maverstr/Lick-Sensor/BillOfMatLickSensor.xlsx

Sheet: Main Material
Material | RS-Reference | URL | Price per component(£, ex. VAT) | Number of components
Arduino Uno | 769-7409 | https://uk.rs-online.com/web/p/processor-microcontroller-development-kits/7697409/ | 15.63 | 1
Hammond 1591, ABS Enclosure, 120x120x94mm | 493-6026 | https://uk.rs-online.com/web/p/general-purpose-enclosures/4936026/ | 10.05 | 1
Solenoid valves VDW22LA | 873-2613 | https://uk.rs-online.com/web/p/solenoid-valves/8732613/ | 18.97 | 2
BNC Connectors | 546-3995 | https://uk.rs-online.com/web/p/bnc-connectors/5463995/ | 2.49 | 4
Push-buttons SPST |  |  | 0.2 | 2
Toggle switches SPST | 419-855 | https://uk.rs-online.com/web/p/toggle-switches/0419855/ | 1.12 | 2
XT60 connectors male | 180-5368 | https://uk.rs-online.com/web/p/compact-power-connectors/1805368/ | 0.768 | 3
XT60 connectors female | 180-5371 | https://uk.rs-online.com/web/p/compact-power-connectors/1805371/ | 0.768 | 3
DC socket 2.5mm | 476-151 | https://uk.rs-online.com/web/p/dc-power-sockets/0476151/ | 6.45 | 1
Pipe to valve adapter, pipes, flow reduction clamp |  |  | 0 | 0
Main material Total |  |  | 87.278
Full total including electronics component sheet: |  |  | 101.003
Full total including electronics component sheet and PCB: |  |  | 116.003
NOTE: Prices are mainly listed from RS components, VAT excluded. Prices taken 24/09/2019.

Sheet: Electronics components
Expensive components | RS-Reference | URL | Price per component(£, ex. VAT) | Number of components
DC/D switching regulators: TSR1-2490 | 666-4376 | https://uk.rs-online.com/web/p/switching-regulators/6664376/ | 6.8 | 1
logic-level MOSFET: IRL540 | 541-1219 | https://uk.rs-online.com/web/p/mosfets/5411219/ | 1.98 | 2
Expensive components Total |  |  | 10.76
Cheap components | RS-Reference | URL | Price per component(£, ex. VAT) | Number of components
Wires |  |  | 0 | 0
Pin headers | 251-8351 | https://uk.rs-online.com/web/p/pcb-headers/2518351/ | 0.725 | 1
Stackable pin headers | Farnell: CN18765 | https://cpc.farnell.com/pro-signal/18689/header-female-stackable-2-54mm/dp/CN18765 | 0.37 | 5
BJT BC547 (or PN2222A, note the reversed pin order) | 671-1113 | https://uk.rs-online.com/web/p/bjt-bipolar-transistors/6711113/ | 0.195 | 2
Cheap components Total: |  |  | 2.965
Resistors (ohms) | Number
10M | 2
1M | 2 | Note:the resistors listed here are the ideal values. A margin of 50-150% is good enough. You can also always place multiple resistors in series or parallel. You may need to slightly adapt the PCB in such case if you don't feel confident soldering multiple resistors on the same slot.
47k | 1
10k | 1
100 | 2
Capacitors (F) | Number
10pF | 1
2.2µF | 1 | not needed if 5V is not used in your design
1µF | 2 | only if your DC/DC converter does not come with integrated filtering capacitors (the TSR1-2490 does implement them)
Diode | Number
1N4001 | 2 | superior voltage diode are also good such as 1N4004
PCB Ordering £1.61 from JLCPCB, additional shipping costs to Leeds, UK using DHL international shipping. Total cost around £15.
