maverstr/Lick-Sensor/Solidworks/xt60MountedPanel.SLDASM

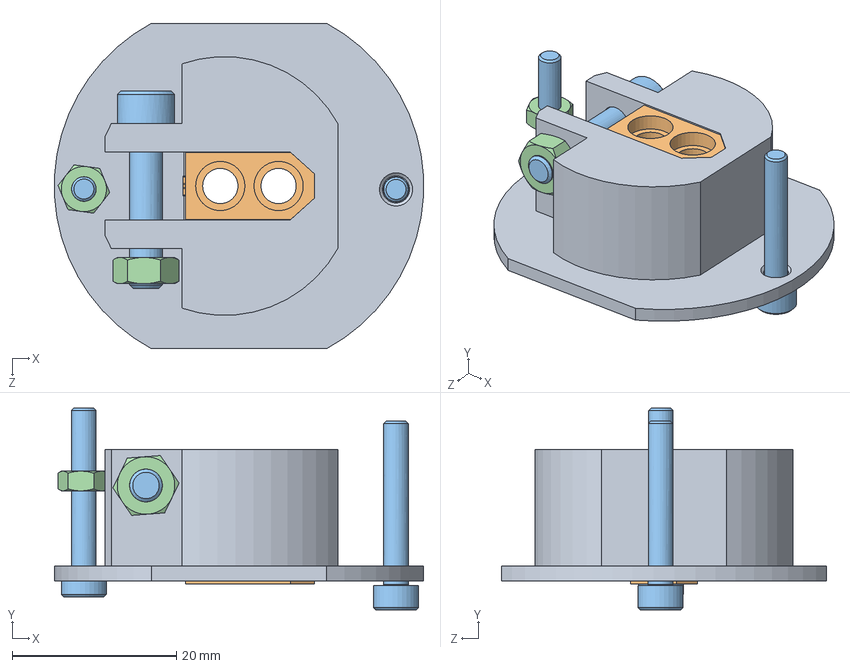
[picture p1: CAD file, 2019-09-27]
Solidworks/xt60MountedPanel.SLDASM
44.9 x 24.6 x 39.6 mm
xt60Mount
XT-60_Macho
socket head cap screw_am x 3
hex nut style 1_am x 2
