maverstr/Lick-Sensor/Solidworks/LickSensorBox.SLDASM

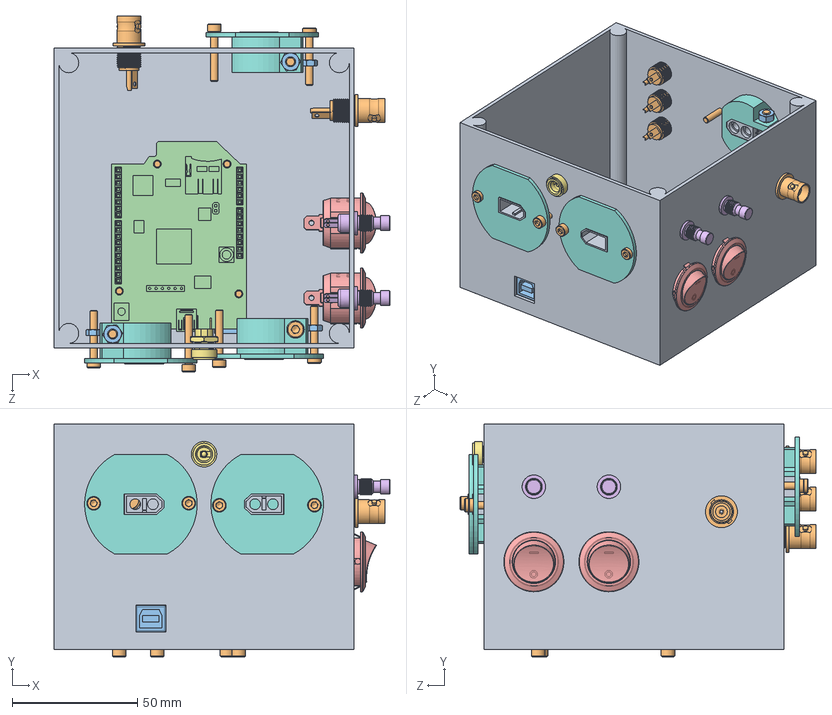
[picture p2: CAD file, 2019-09-27]
Solidworks/LickSensorBox.SLDASM
134.3 x 93.0 x 142.3 mm
Enclosure
Amphenal_031_10_RFXG1 x 4
Arduino UNO
Arduino_Wifi_Shield
Bouton 2 Positions Green x 2
Button Push x 2
DC Jack Panel Mount ASSY
xt60Mount x 3
XT-60_Macho x 3
socket head cap screw_am x 13
hex nut style 1_am x 6
