maverstr/Lick-Sensor/Solidworks/DC Jack Panel Mount ASSY.SLDPRT

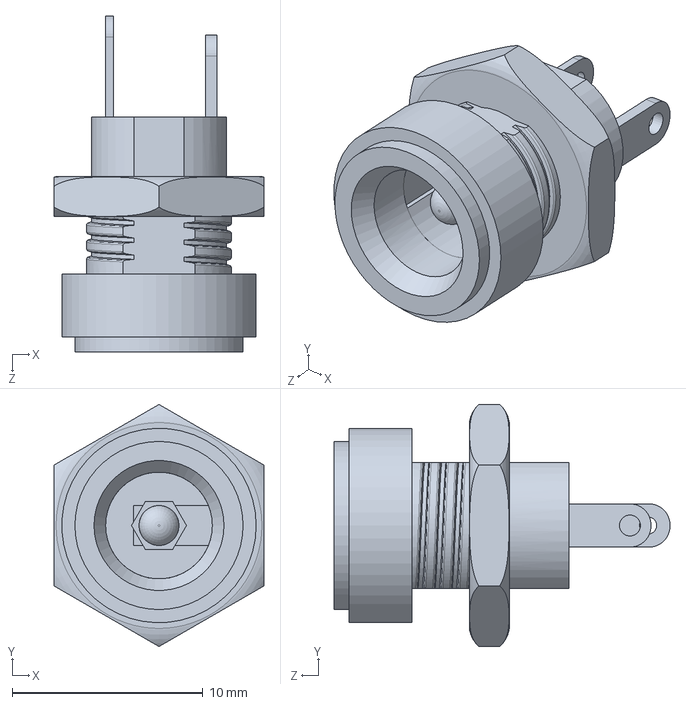
[picture p3: CAD file, 2019-09-27]
Solidworks/DC Jack Panel Mount ASSY.SLDPRT
11.0 x 12.7 x 17.6 mm
