maverstr/Lick-Sensor/Solidworks/Bouton 2 Positions Green.SLDPRT

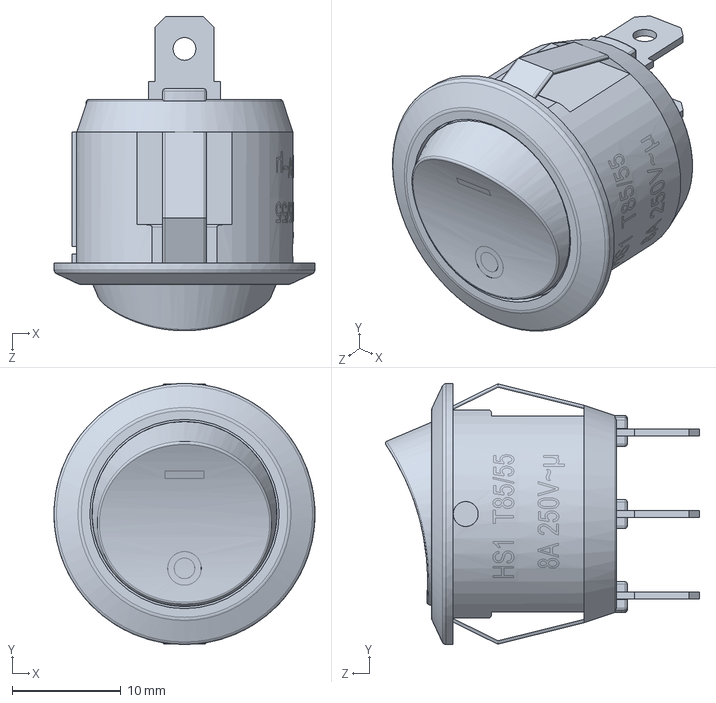
[picture p4: CAD file, 2019-09-27]
Solidworks/Bouton 2 Positions Green.SLDPRT
24.0 x 24.0 x 28.9 mm
