maverstr/Lick-Sensor/Solidworks/XT-60_Macho 1.SLDPRT

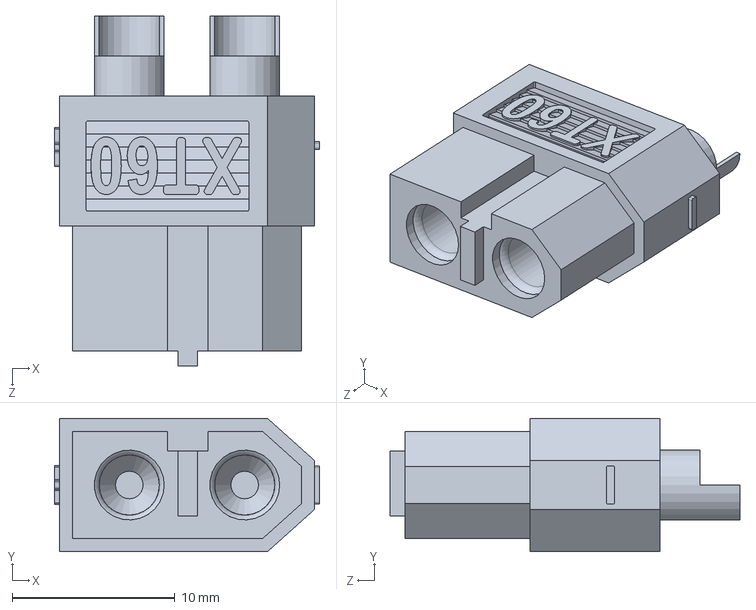
[picture p5: CAD file, 2019-09-27]
Solidworks/XT-60_Macho 1.SLDPRT
16.3 x 8.20 x 21.5 mm
