maverstr/Lick-Sensor/Solidworks/xt60Mount.SLDPRT

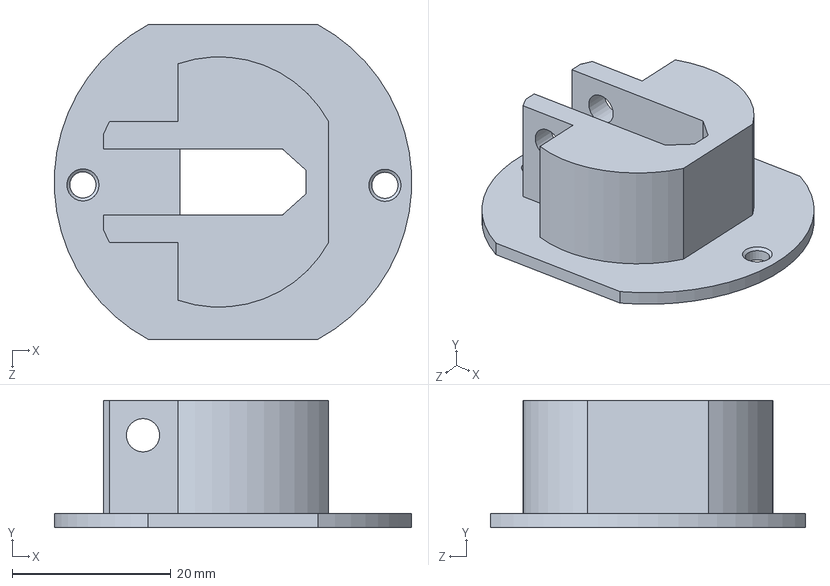
[picture p6: CAD file, 2019-09-27]
Solidworks/xt60Mount.SLDPRT
44.9 x 16.0 x 39.6 mm
