maverstr/Lick-Sensor/Solidworks/XT-60_Macho.SLDPRT

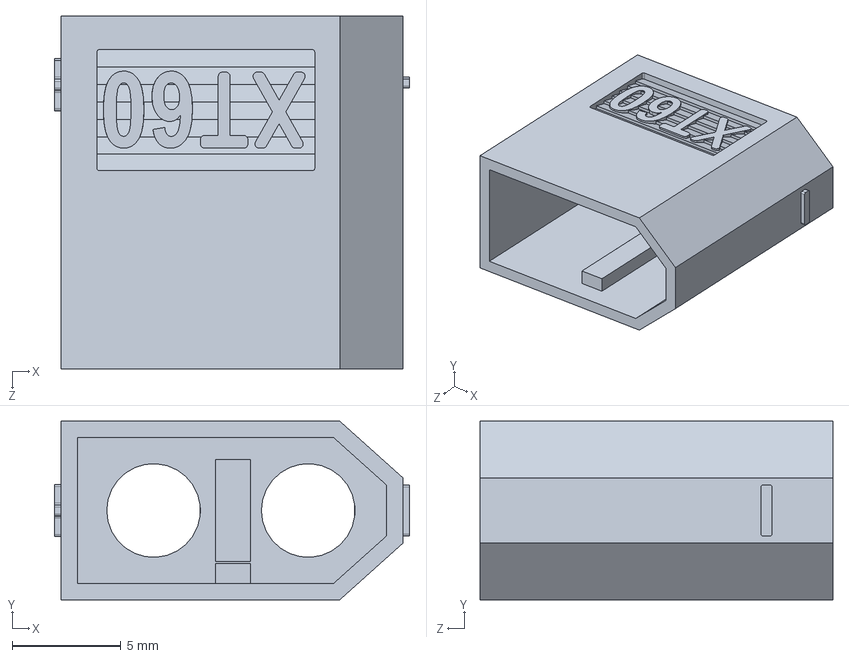
[picture p7: CAD file, 2019-09-27]
Solidworks/XT-60_Macho.SLDPRT
16.3 x 8.20 x 16.2 mm
