maverstr/Lick-Sensor/Solidworks/Enclosure.SLDPRT

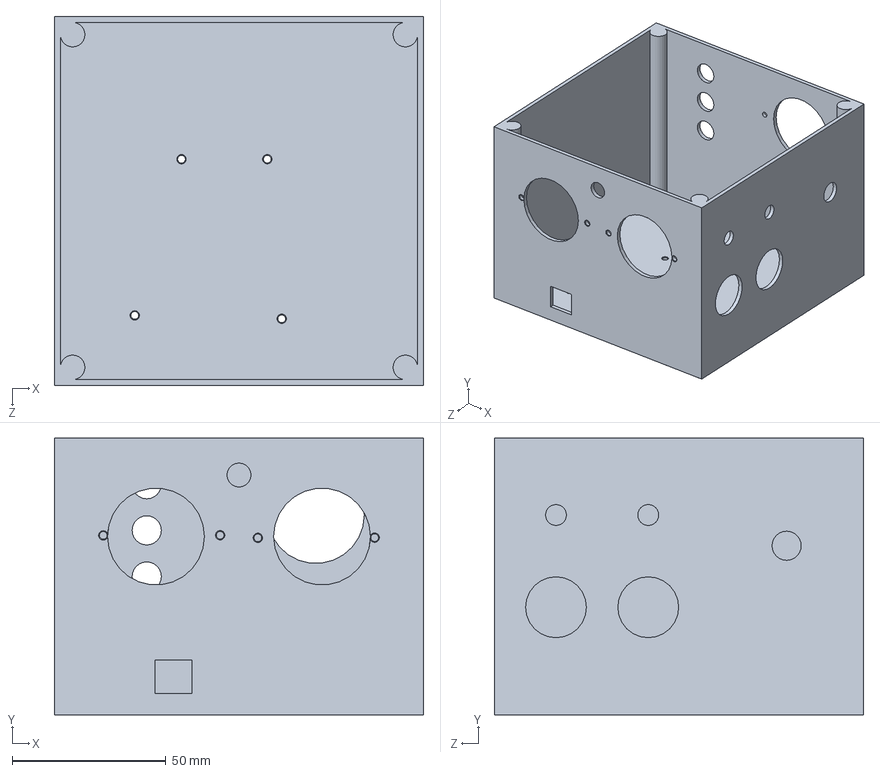
[picture p8: CAD file, 2019-09-27]
Solidworks/Enclosure.SLDPRT
120.0 x 90.0 x 120.0 mm
