maverstr/Lick-Sensor/Solidworks/Arduino UNO.SLDPRT

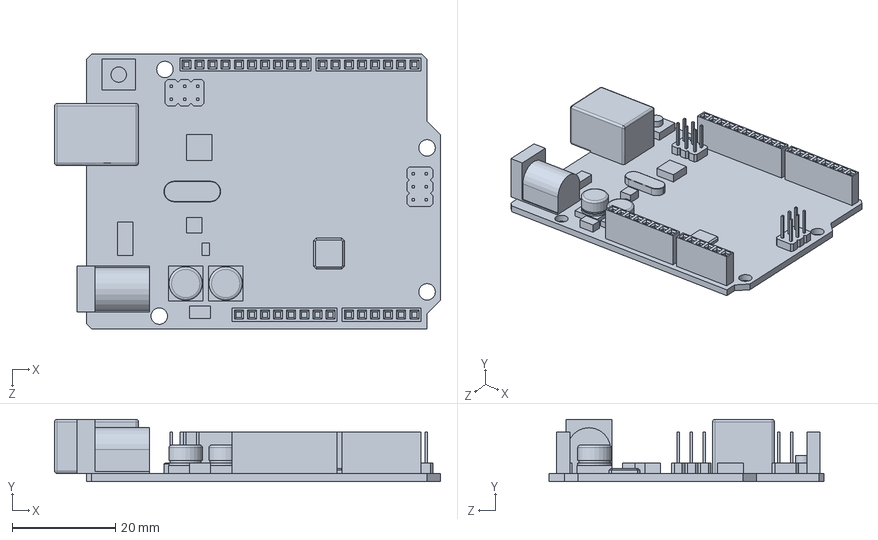
[picture p9: CAD file, 2019-09-27]
Solidworks/Arduino UNO.SLDPRT
74.8 x 12.1 x 53.3 mm
