maverstr/Lick-Sensor/Solidworks/Arduino_Wifi_Shield.SLDPRT

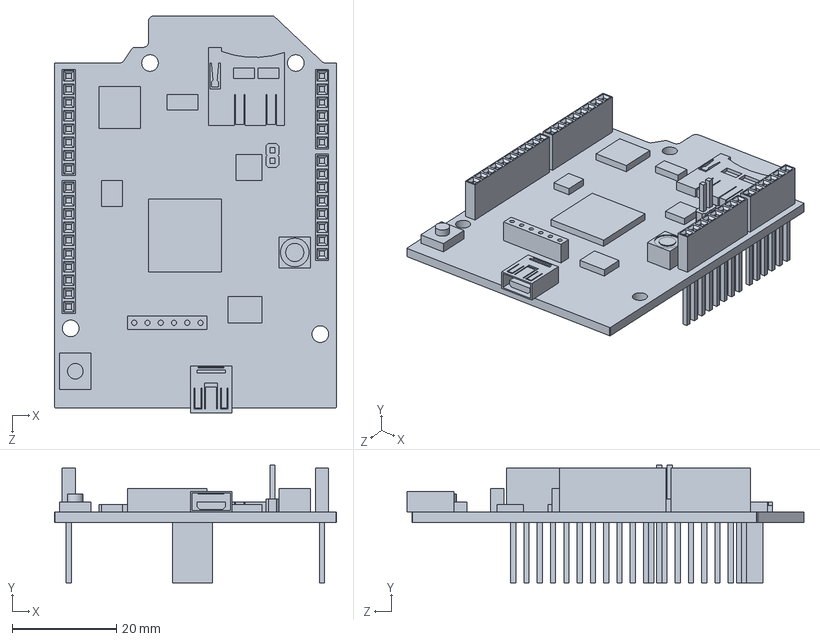
[picture p10: CAD file, 2019-09-27]
Solidworks/Arduino_Wifi_Shield.SLDPRT
54.0 x 22.5 x 76.0 mm
