maverstr/Lick-Sensor/Solidworks/Button Push.SLDPRT

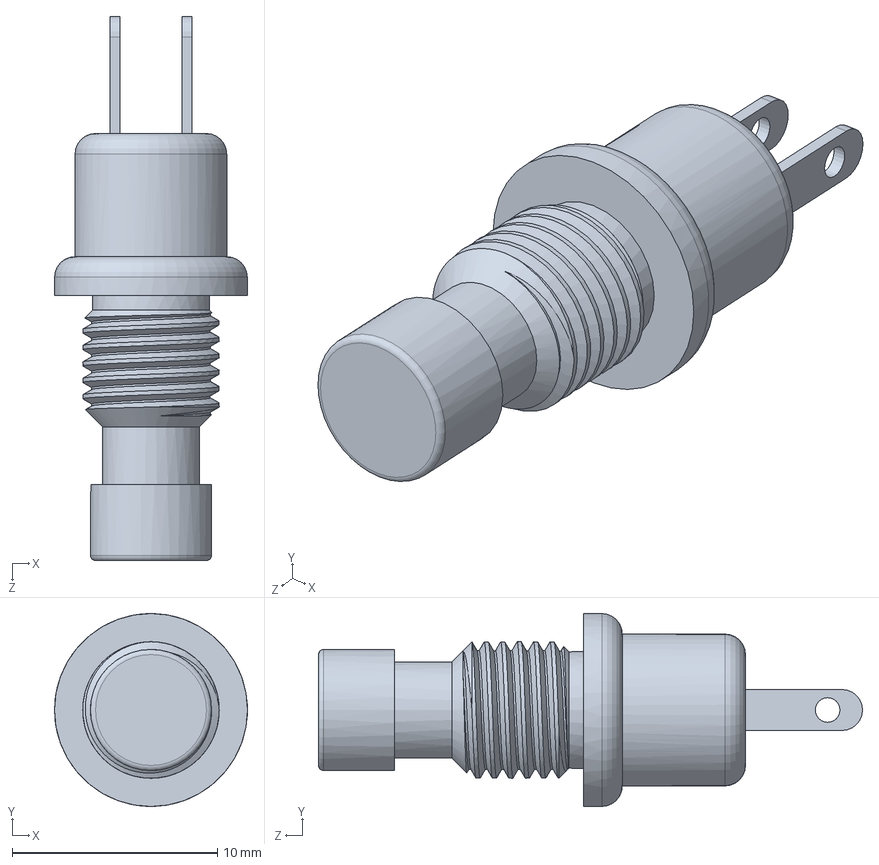
[picture p11: CAD file, 2019-09-27]
Solidworks/Button Push.SLDPRT
9.40 x 9.40 x 26.5 mm
