maverstr/Lick-Sensor/Solidworks/Amphenal_031_10_RFXG1.SLDPRT

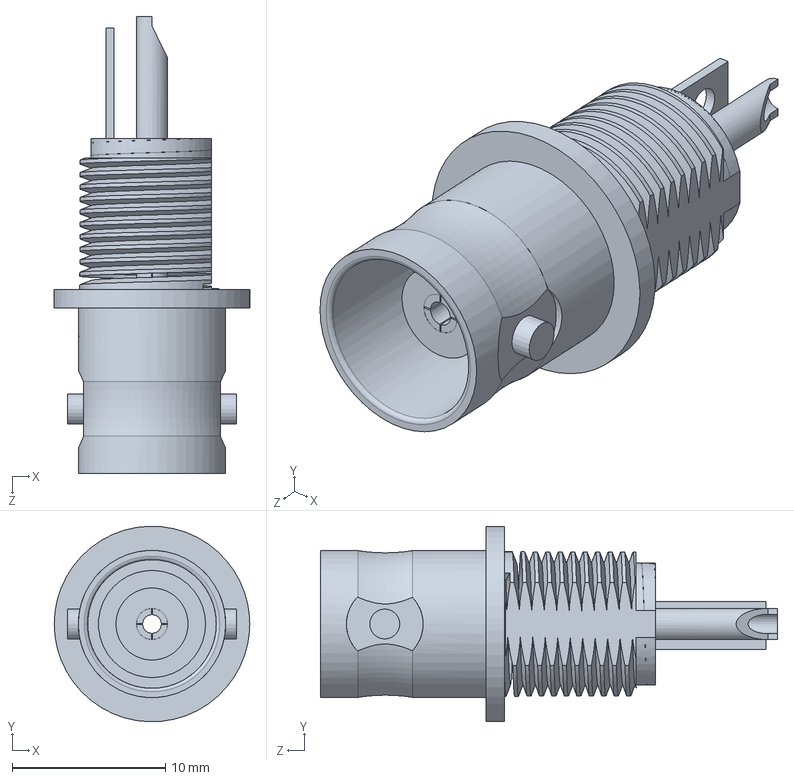
[picture p12: CAD file, 2019-09-27]
Solidworks/Amphenal_031_10_RFXG1.SLDPRT
12.8 x 12.7 x 29.8 mm
