maverstr/Lick-Sensor/Solidworks/xt60MountV2.STL

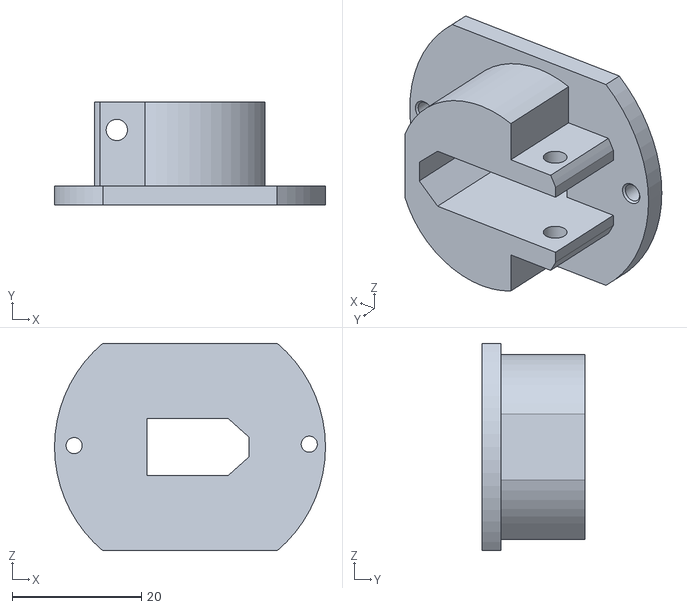
[picture p13: CAD file, 2019-09-27, an earlier design]
Solidworks/xt60MountV2.STL
42.0 x 16.0 x 32.2
