maverstr/Lick-Sensor/Solidworks/xt60MountV3.STL

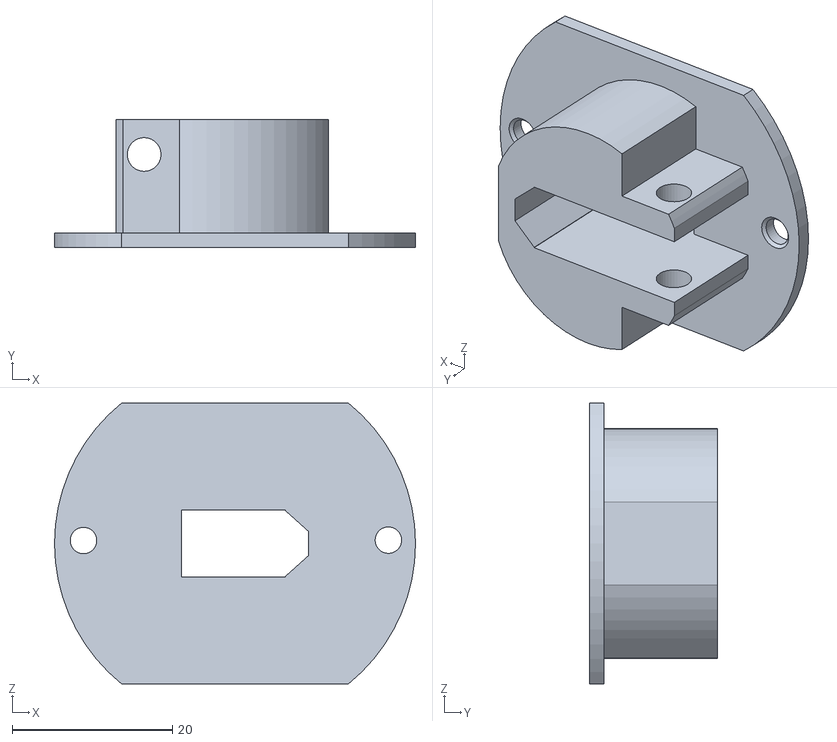
[picture p14: CAD file, 2019-09-27, an earlier design]
Solidworks/xt60MountV3.STL
45.0 x 16.0 x 35.0
