maverstr/Lick-Sensor/(list of files, cad)

Other CAD files:
Solidworks/xt60MountV3_5.STL
Solidworks/Enclosure1.SLDDRW
Solidworks/Enclosure2.SLDDRW
Solidworks/xt60Mount.STL
