maverstr/Lick-Sensor/Solidworks/Enclosure1.PDF

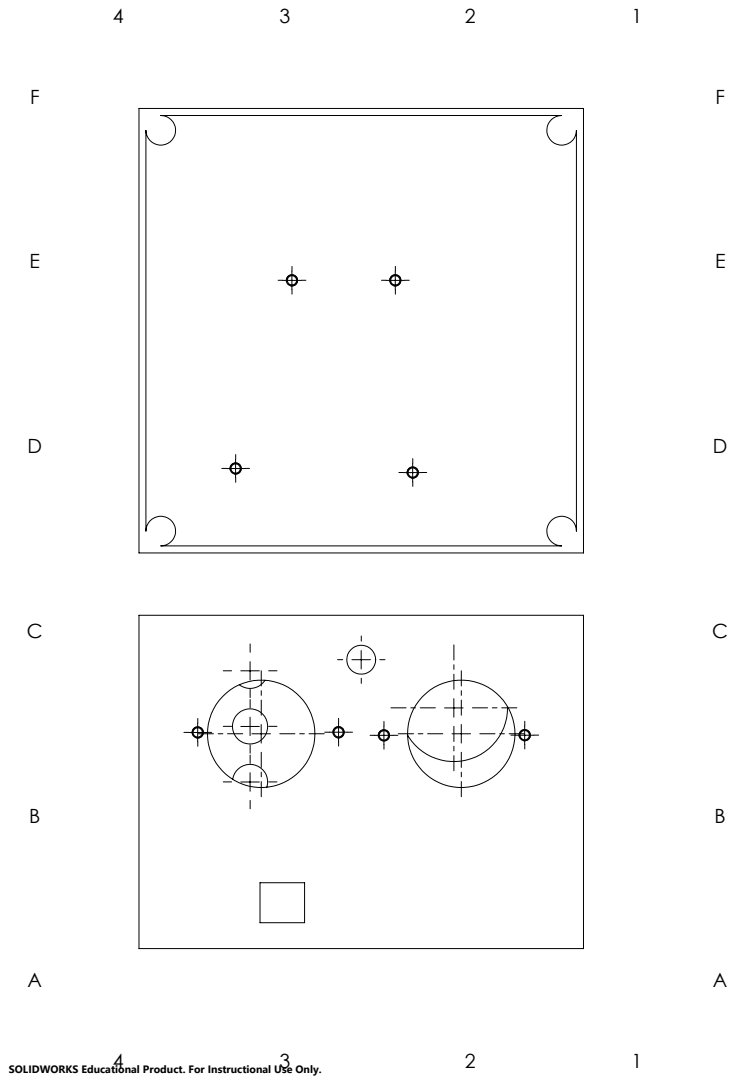
[picture p29: page 1]

SOLIDWORKS Educational Product. For Instructional Use Only.
