maverstr/Lick-Sensor/Solidworks/Enclosure2.PDF

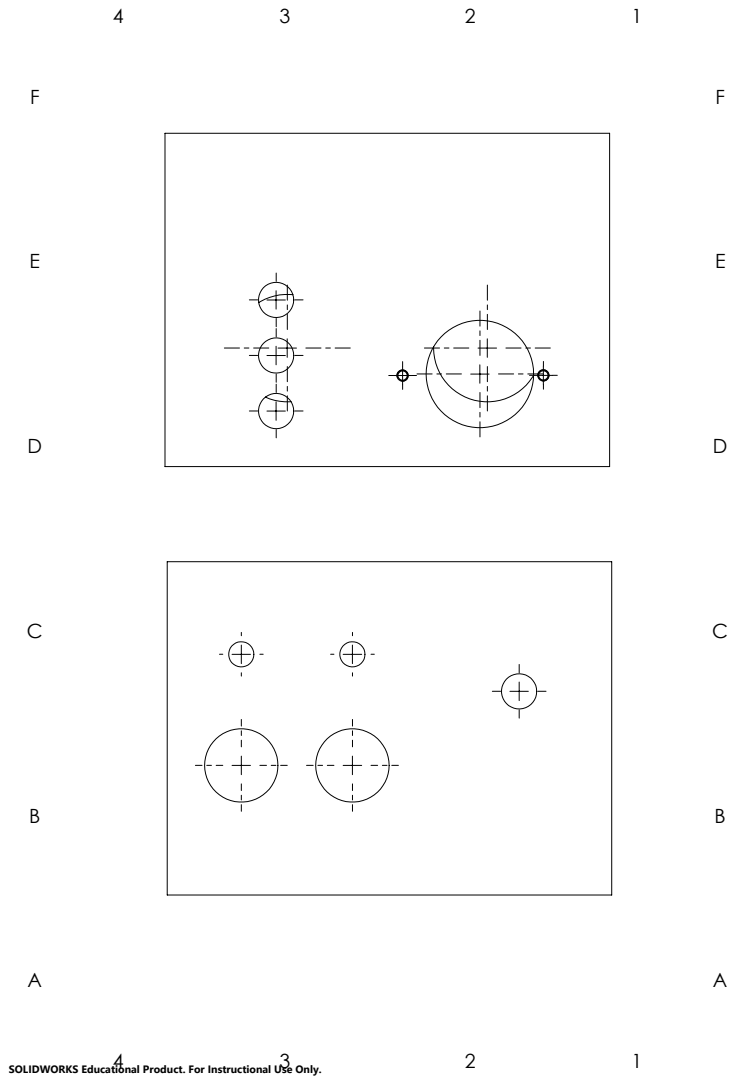
[picture p30: page 1]

SOLIDWORKS Educational Product. For Instructional Use Only.
