maverstr/Lick-Sensor/Solidworks/Enclosure3.PDF

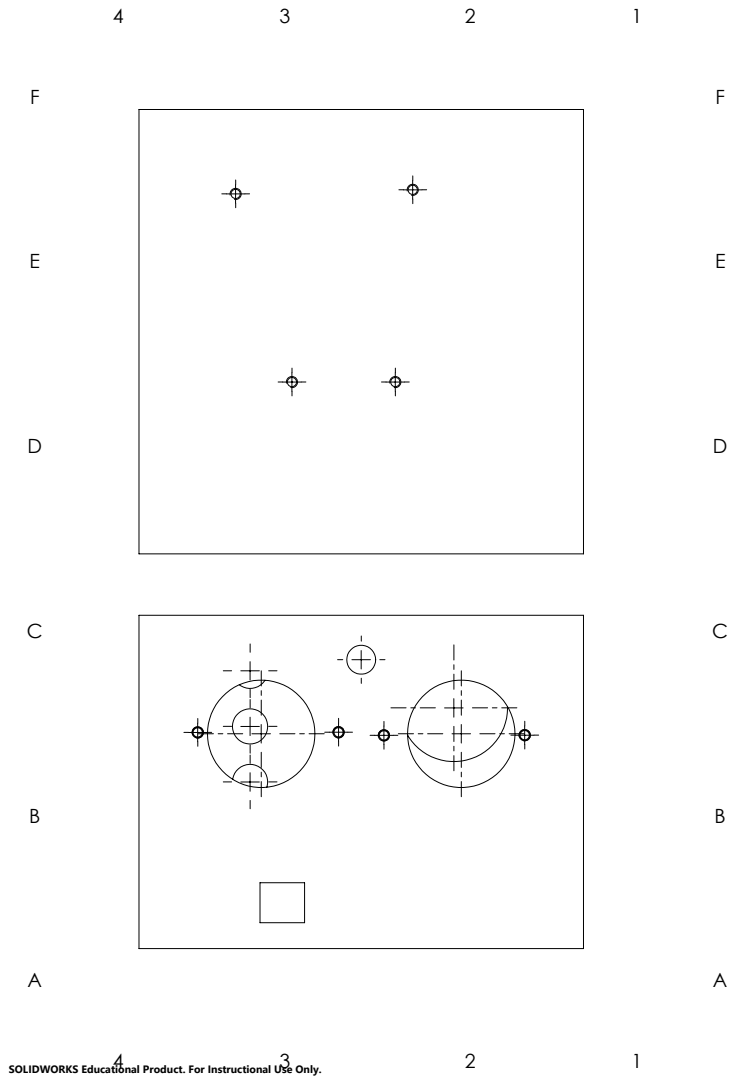
[picture p31: page 1]

SOLIDWORKS Educational Product. For Instructional Use Only.
