maverstr/Lick-Sensor/LickSensor_EAGLE_FILES_COPY/LickSensor_V3.brd

## EAGLE design LickSensor_EAGLE_FILES_COPY/LickSensor_V3.brd (2019-09-25)

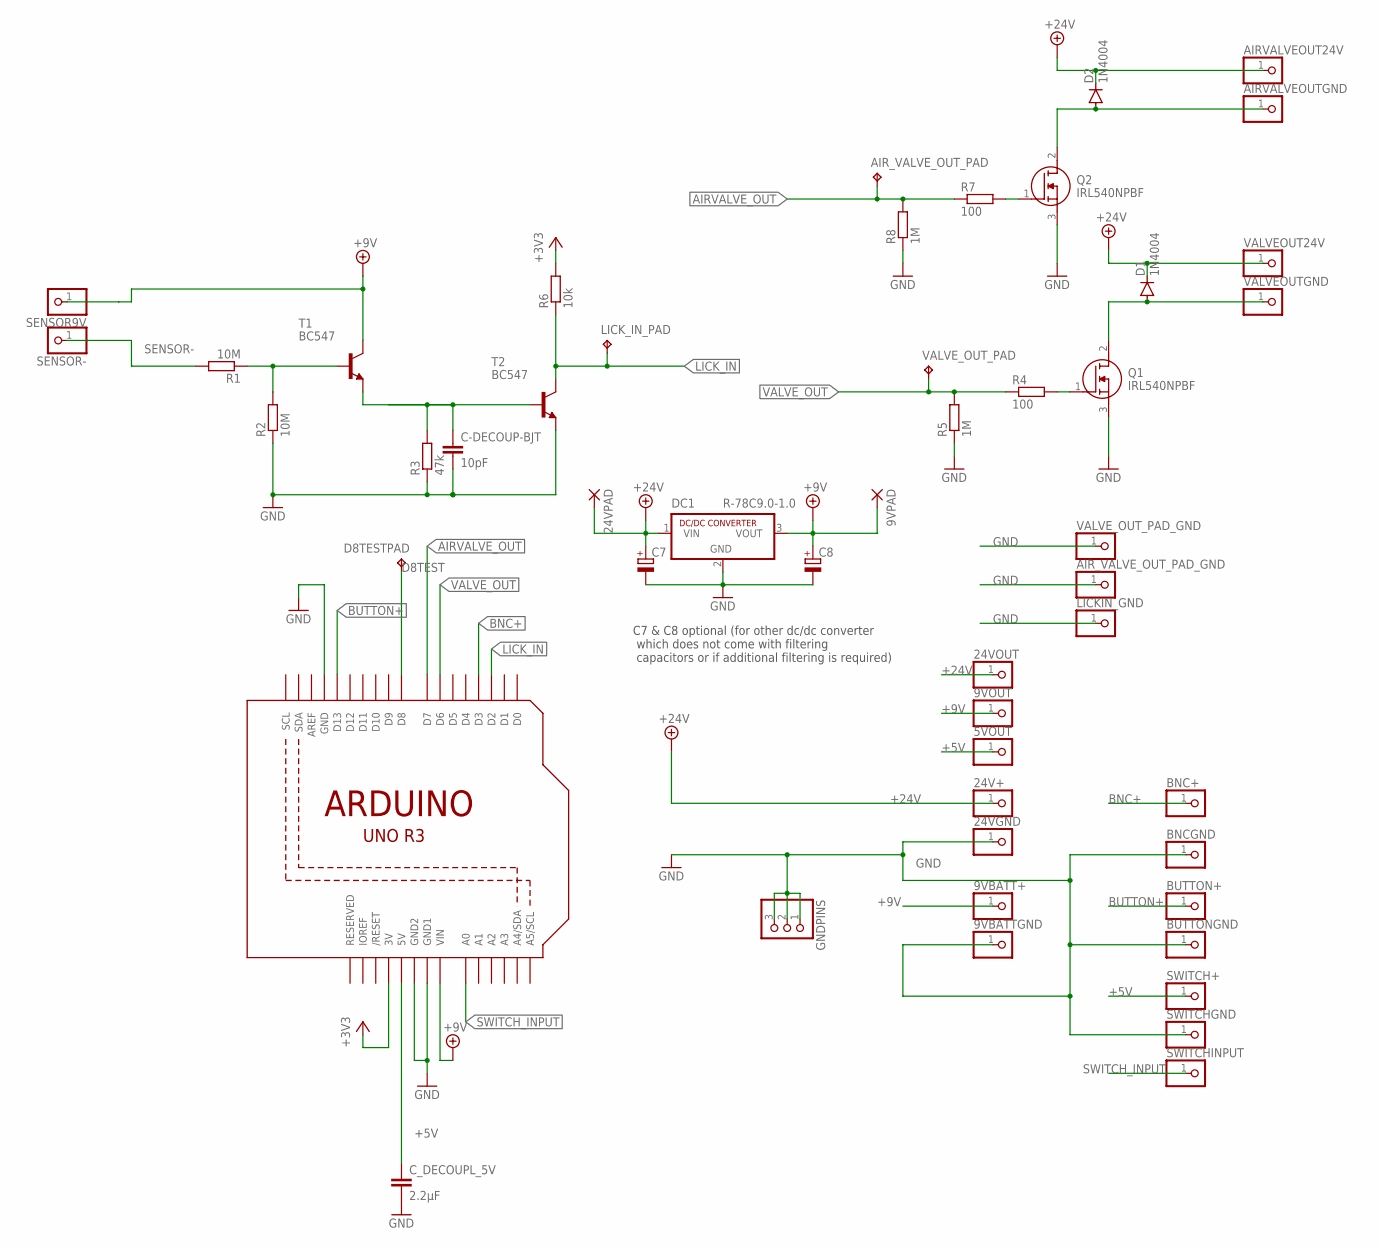
[picture p32: schematic LickSensor_V3.sch]

Parts:
5VOUT, 9VBATT+, 9VBATTGND, 9VOUT, 24V+, 24VGND, 24VOUT: PINHD-1X1; 1X01
9VPAD, 24VPAD: 1,6/0,8
AIRVALVEOUT24V: PINHD-1X1; 1X01
AIRVALVEOUTGND: PINHD-1X1; 1X01
AIR_VALVE_OUT_PAD: TPPAD1-13; P1-13
AIR_VALVE_OUT_PAD_GND: PINHD-1X1; 1X01
BNC+: PINHD-1X1; 1X01
BNCGND: PINHD-1X1; 1X01
BUTTON+: PINHD-1X1; 1X01
BUTTONGND: PINHD-1X1; 1X01
C7, C8: CPOL-EUTT2D6; TT2D6
C-DECOUP-BJT: 10pF; C050-030X075
C_DECOUPL_5V: 2.2µF; C050-030X075
D1, D2: 1N4004; DO41-10
D8TESTPAD: TPPAD1-13; P1-13
DC1: R-78C9.0-1.0; SIP3
GNDPINS: PINHD-1X3; 1X03
LICKIN_GND: PINHD-1X1; 1X01
LICK_IN_PAD: TPPAD1-13; P1-13
Q1, Q2: IRL540NPBF; TO254P469X1042X1967-3P
R1, R2: 10M; 0207/7
R3: 47k; 0207/7
R4, R7: 100; 0204/7
R5, R8: 1M; 0204/7
R6: 10k; 0204/7
SENSOR9V: PINHD-1X1; 1X01
SENSOR-: PINHD-1X1; 1X01
SWITCH+: PINHD-1X1; 1X01
SWITCHGND: PINHD-1X1; 1X01
SWITCHINPUT: PINHD-1X1; 1X01
T1, T2: BC547; TO92
U1: ARDUINOR3-DIMENSION; ARDUINOR3
VALVEOUT24V: PINHD-1X1; 1X01
VALVEOUTGND: PINHD-1X1; 1X01
VALVE_OUT_PAD: TPPAD1-13; P1-13
VALVE_OUT_PAD_GND: PINHD-1X1; 1X01

Connections:
+3V3: R6.2, U1.3V
+5V: 5VOUT.1, C_DECOUPL_5V.1, SWITCH+.1, U1.5V
+9V: 9VBATT+.1, 9VOUT.1, 9VPAD.1, C8.+, DC1.3 (VOUT), SENSOR9V.1, T1.3 (C), U1.VIN
+24V: 24V+.1, 24VOUT.1, 24VPAD.1, AIRVALVEOUT24V.1, C7.+, D1.C, D2.C, DC1.1 (VIN), VALVEOUT24V.1
AIRVALVE_OUT: AIR_VALVE_OUT_PAD.TP, R7.1, R8.2, U1.D7
BNC+: BNC+.1, U1.D3
BUTTON+: BUTTON+.1, U1.D13
D8TEST: D8TESTPAD.TP, U1.D8
GND: 9VBATTGND.1, 24VGND.1, AIR_VALVE_OUT_PAD_GND.1, BNCGND.1, BUTTONGND.1, C7.-, C8.-, C-DECOUP-BJT.2, C_DECOUPL_5V.2, DC1.2 (GND), GNDPINS.1, GNDPINS.2, GNDPINS.3, LICKIN_GND.1, Q1.3 (S), Q2.3 (S), R2.1, R3.1, R5.1, R8.1, SWITCHGND.1, T2.1 (E), U1.GND, U1.GND1, U1.GND2, VALVE_OUT_PAD_GND.1
GND1: D1.A, Q1.2 (D), VALVEOUTGND.1
GND2: AIRVALVEOUTGND.1, D2.A, Q2.2 (D)
LICK_IN: LICK_IN_PAD.TP, R6.1, T2.3 (C), U1.D2
unnamed: Q2.1 (G), R7.2
unnamed: Q1.1 (G), R4.2
unnamed: C-DECOUP-BJT.1, R3.2, T1.1 (E), T2.2 (B)
unnamed: R1.1, R2.2, T1.2 (B)
SENSOR-: R1.2, SENSOR-.1
SWITCH_INPUT: SWITCHINPUT.1, U1.A0
VALVE_OUT: R4.1, R5.2, U1.D6, VALVE_OUT_PAD.TP

Notes on the sheet:
C7 & C8 optional (for other dc/dc converter which does not come with filtering capacitors or if additional filtering is required)

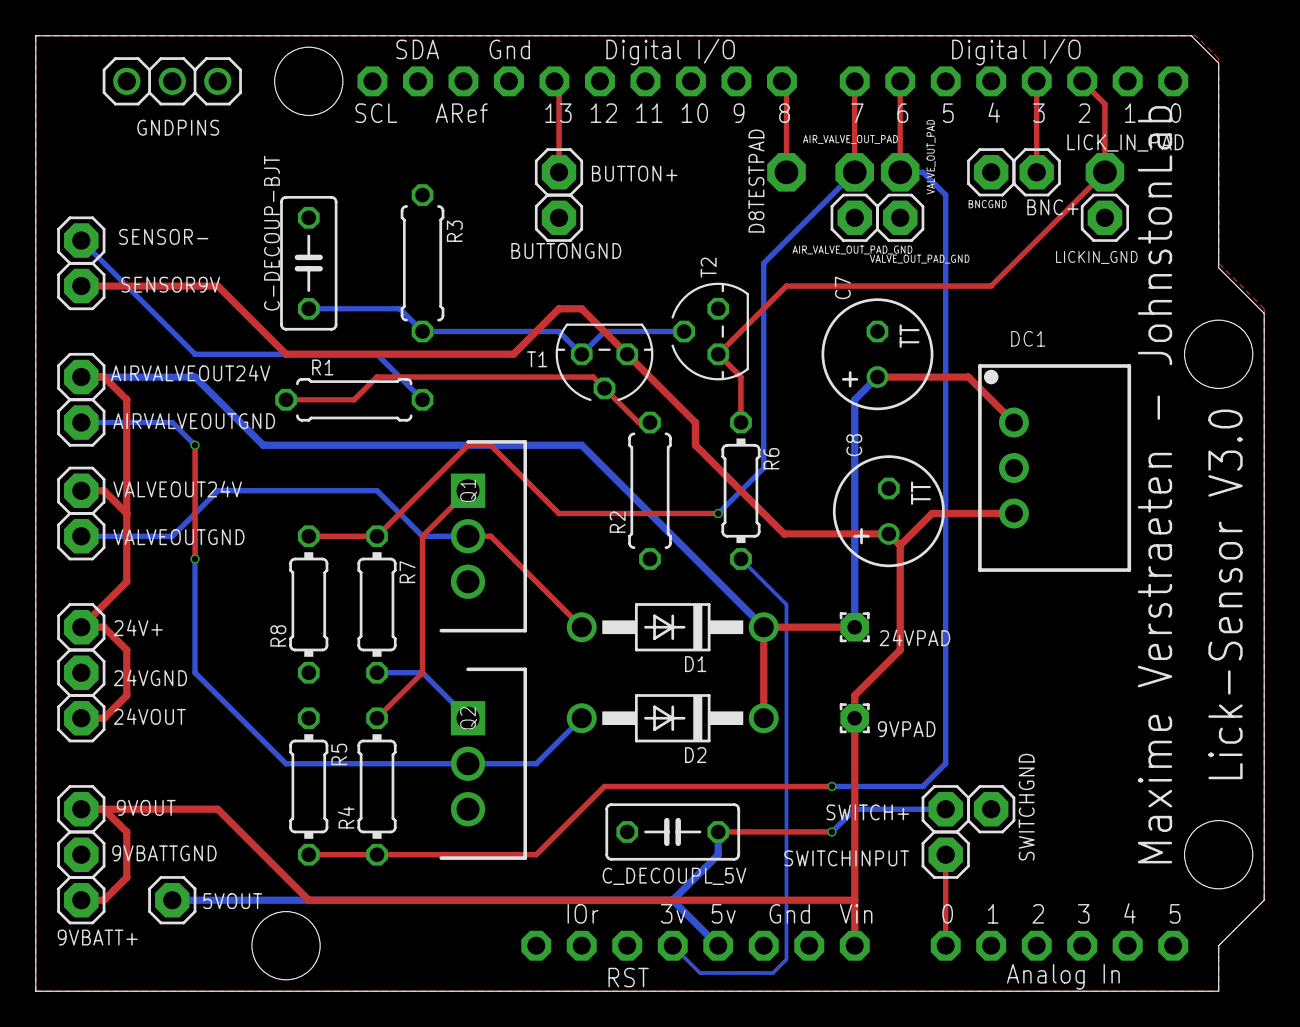
[picture p33: board LickSensor_V3.brd from above]

Board: 2 copper layers, 68.6 x 53.3 mm, 50 parts (0 on the bottom side), 19 nets.
