maverstr/Lick-Sensor/LickSensor_EAGLE_FILES_COPY/LickSensor.brd

## EAGLE design LickSensor_EAGLE_FILES_COPY/LickSensor.brd (2019-09-16, an earlier design)

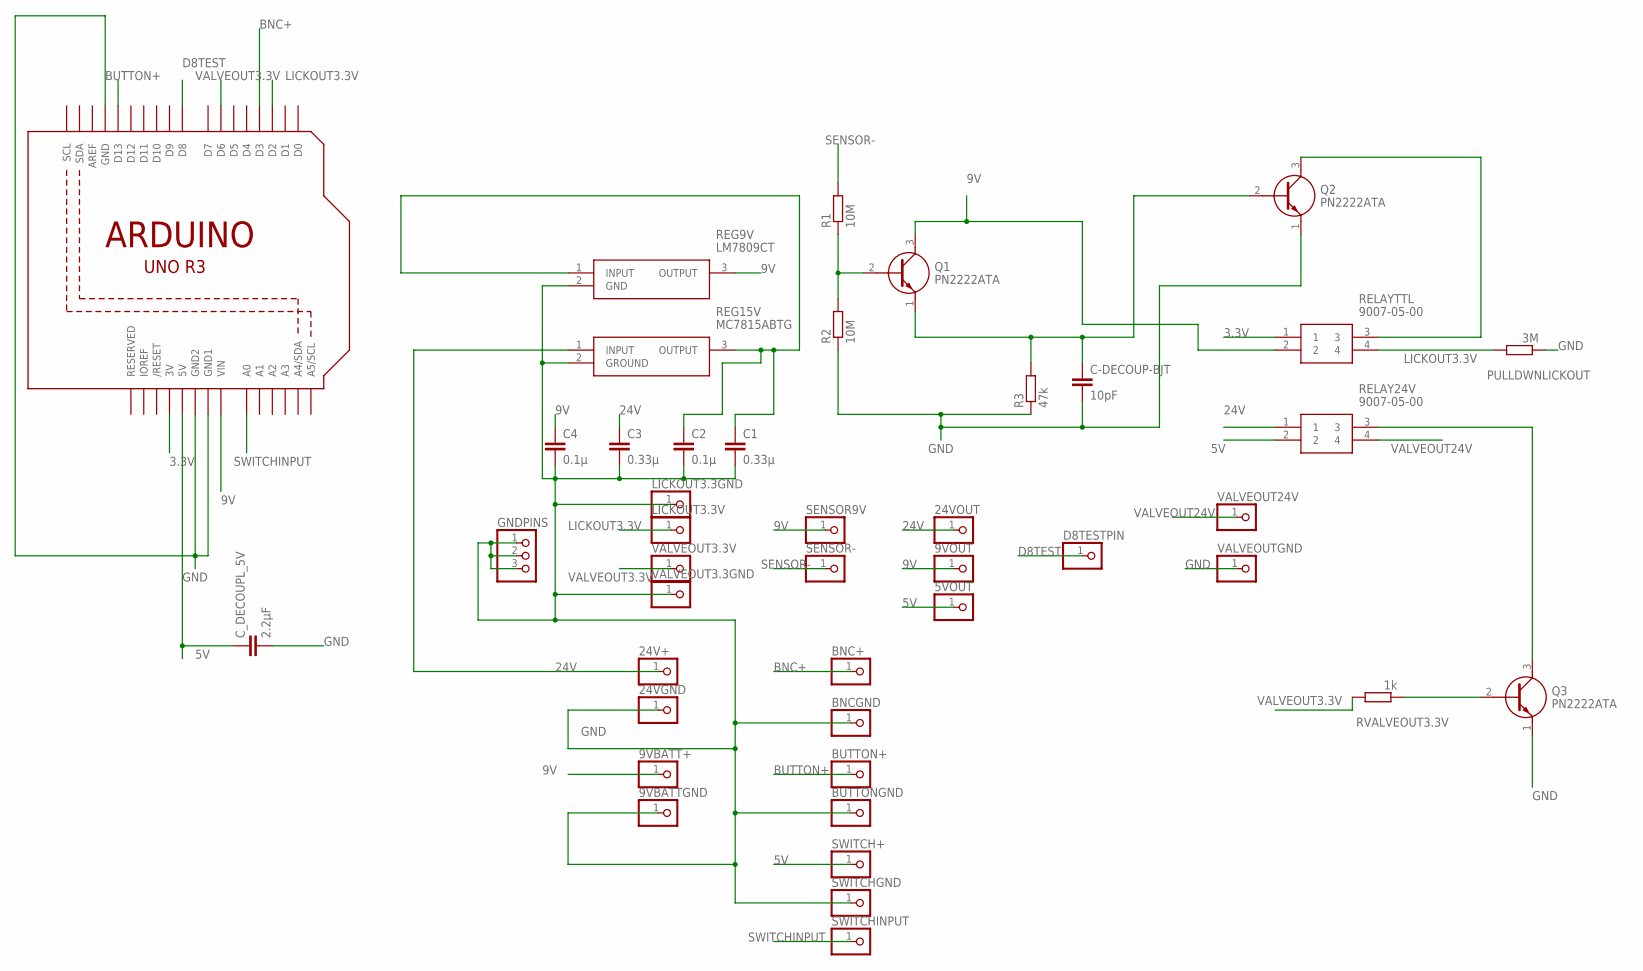
[picture p34: schematic LickSensor.sch]

Parts:
5VOUT, 9VBATT+, 9VBATTGND, 9VOUT, 24V+, 24VGND, 24VOUT: PINHD-1X1; 1X01
BNC+: PINHD-1X1; 1X01
BNCGND: PINHD-1X1; 1X01
BUTTON+: PINHD-1X1; 1X01
BUTTONGND: PINHD-1X1; 1X01
C1, C3: 0.33µ; C5B2.5
C2, C4: 0.1µ; C5B2.5
C-DECOUP-BJT: 10pF; C050-030X075
C_DECOUPL_5V: 2.2µF; C050-030X075
D8TESTPIN: PINHD-1X1; 1X01
GNDPINS: PINHD-1X3; 1X03
LICKOUT3.3GND, LICKOUT3.3V: PINHD-1X1; 1X01
PULLDWNLICKOUT: 3M; 0207/10
Q1, Q2, Q3: PN2222ATA; TO-92-3
R1, R2: 10M; 0207/7
R3: 47k; 0207/7
REG9V: LM7809CT; TO254P470X1016X2019-3P
REG15V: MC7815ABTG; TO254P482X997X2018-3P
RELAY24V: 9007-05-00; 9007
RELAYTTL: 9007-05-00; 9007
RVALVEOUT3.3V: 1k; 0207/10
SENSOR9V: PINHD-1X1; 1X01
SENSOR-: PINHD-1X1; 1X01
SWITCH+: PINHD-1X1; 1X01
SWITCHGND: PINHD-1X1; 1X01
SWITCHINPUT: PINHD-1X1; 1X01
U1: ARDUINOR3-DIMENSION; ARDUINOR3
VALVEOUT3.3GND, VALVEOUT3.3V, VALVEOUT24V: PINHD-1X1; 1X01
VALVEOUTGND: PINHD-1X1; 1X01

Connections:
3.3V: RELAYTTL.1, U1.3V
5V: 5VOUT.1, C_DECOUPL_5V.1, RELAY24V.2, SWITCH+.1, U1.5V
9V: 9VBATT+.1, 9VOUT.1, C4.1, Q1.3 (C), REG9V.3 (OUTPUT), RELAYTTL.2, SENSOR9V.1, U1.VIN
24V: 24V+.1, 24VOUT.1, C3.1, REG15V.1 (INPUT), RELAY24V.1
BNC+: BNC+.1, U1.D3
BUTTON+: BUTTON+.1, U1.D13
D8TEST: D8TESTPIN.1, U1.D8
GND: 9VBATTGND.1, 24VGND.1, BNCGND.1, BUTTONGND.1, C1.2, C2.2, C3.2, C4.2, C-DECOUP-BJT.2, C_DECOUPL_5V.2, GNDPINS.1, GNDPINS.2, GNDPINS.3, LICKOUT3.3GND.1, PULLDWNLICKOUT.1, Q2.1 (E), Q3.1 (E), R2.1, R3.1, REG9V.2 (GND), REG15V.2 (GROUND), SWITCHGND.1, U1.GND, U1.GND1, U1.GND2, VALVEOUT3.3GND.1, VALVEOUTGND.1
LICKOUT3.3V: LICKOUT3.3V.1, PULLDWNLICKOUT.2, RELAYTTL.4, U1.D2
unnamed: Q3.2 (B), RVALVEOUT3.3V.1
unnamed: Q3.3 (C), RELAY24V.3
unnamed: C1.1, C2.1, REG9V.1 (INPUT), REG15V.3 (OUTPUT)
unnamed: C-DECOUP-BJT.1, Q1.1 (E), Q2.2 (B), R3.2
unnamed: Q1.2 (B), R1.1, R2.2
unnamed: Q2.3 (C), RELAYTTL.3
SENSOR-: R1.2, SENSOR-.1
SWITCHINPUT: SWITCHINPUT.1, U1.A0
VALVEOUT3.3V: RVALVEOUT3.3V.2, U1.D6, VALVEOUT3.3V.1
VALVEOUT24V: RELAY24V.4, VALVEOUT24V.1

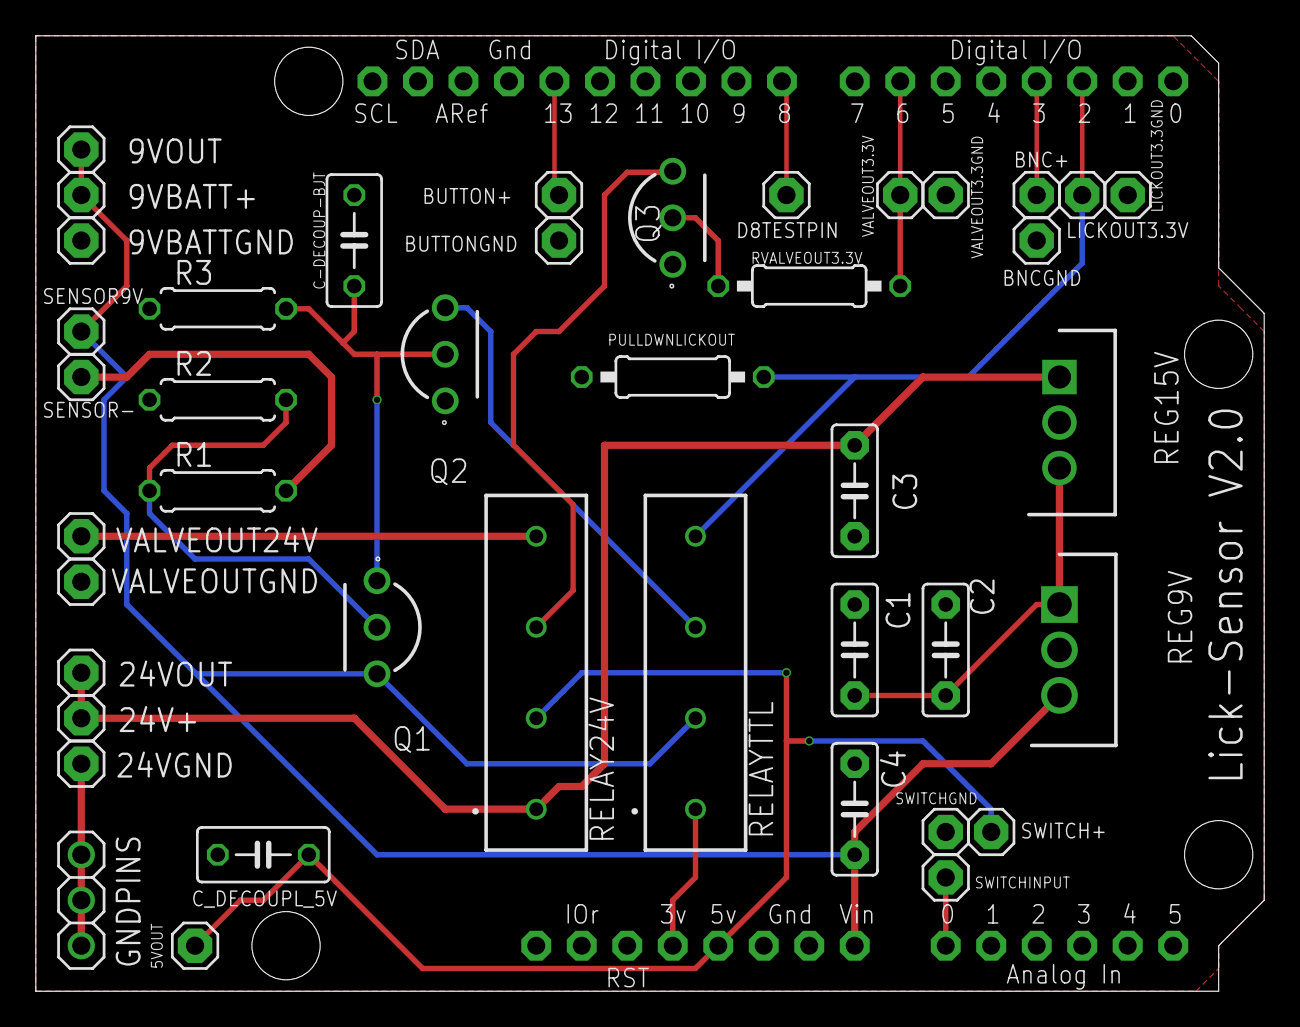
[picture p35: board LickSensor.brd from above]

Board: 2 copper layers, 68.6 x 53.3 mm, 43 parts (0 on the bottom side), 19 nets.
