maverstr/Lick-Sensor/LickSensor_EAGLE_FILES_COPY/LickSensor_V2.brd

## EAGLE design LickSensor_EAGLE_FILES_COPY/LickSensor_V2.brd (2019-09-16, an earlier design)

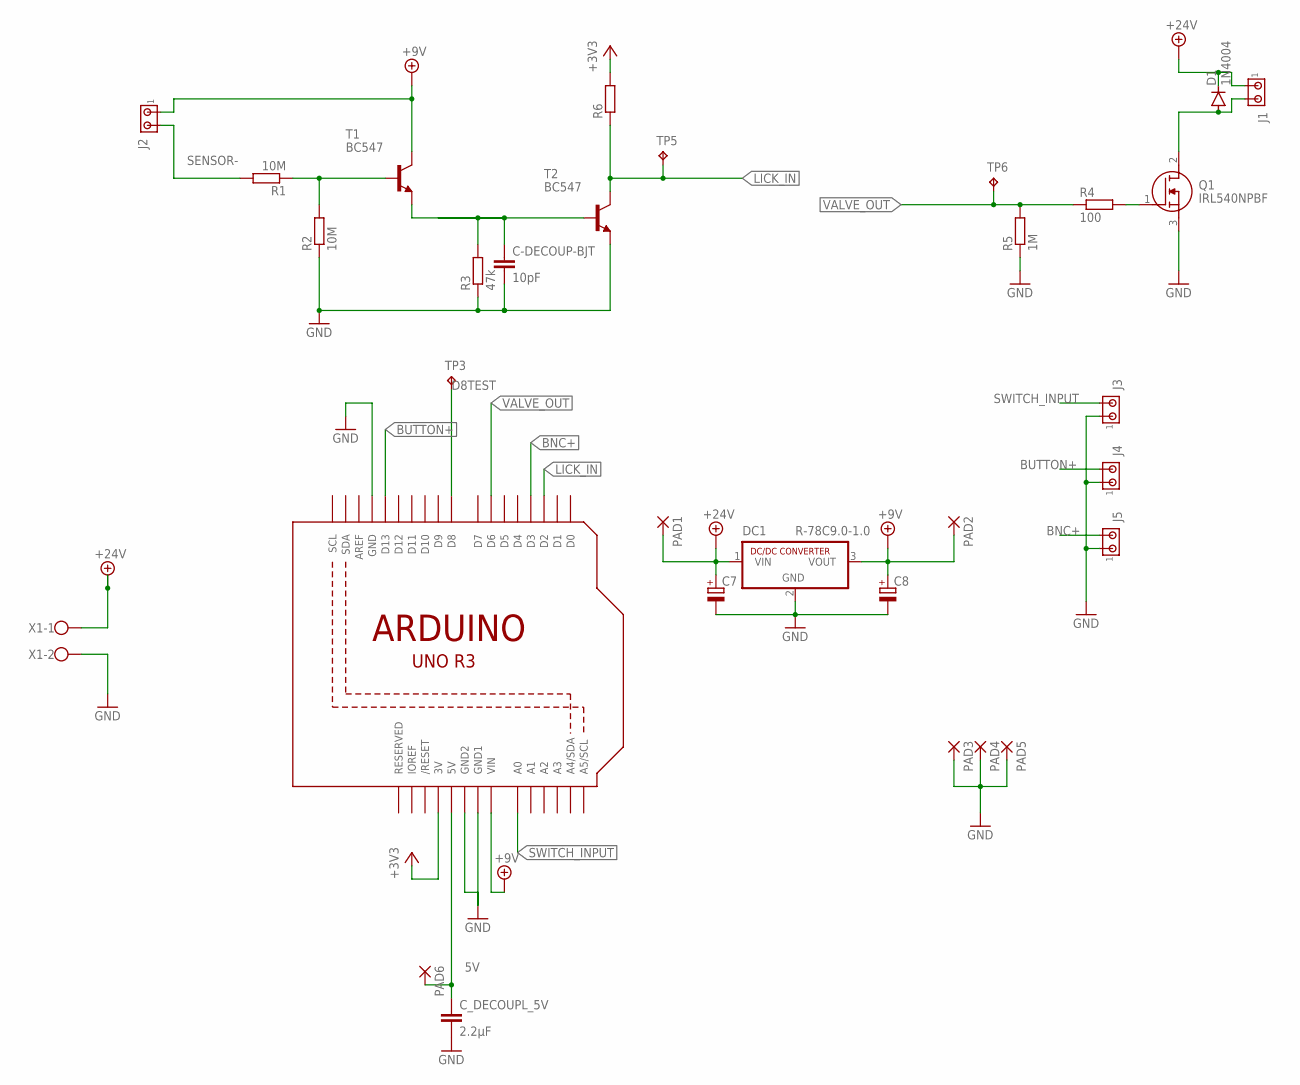
[picture p36: schematic LickSensor_V2.sch]

Parts:
C7, C8: CPOL-EUTT2D6; TT2D6
C-DECOUP-BJT: 10pF; C050-030X075
C_DECOUPL_5V: 2.2µF; C050-030X075
D1: 1N4004; DO41-10
DC1: R-78C9.0-1.0; SIP3
J1, J2, J3, J4, J5: MTA02-100; 10X02MTA
PAD1, PAD2, PAD3, PAD4, PAD5, PAD6: 1,6/0,8
Q1: IRL540NPBF; TO254P469X1042X1967-3P
R1, R2: 10M; 0207/7
R3: 47k; 0207/7
R4: 100; 0204/7
R5: 1M; 0204/7
R6: R-EU_0204/7; 0204/7
T1, T2: BC547; TO92
TP3, TP5, TP6: TPPAD1-13; P1-13
U1: ARDUINOR3-DIMENSION; ARDUINOR3
X1: W237-102

Connections:
5V: C_DECOUPL_5V.1, PAD6.1, U1.5V
+3V3: R6.2, U1.3V
+9V: C8.+, DC1.3 (VOUT), J2.1, PAD2.1, T1.3 (C), U1.VIN
+24V: C7.+, D1.C, DC1.1 (VIN), J1.1, PAD1.1, X1.1
BNC+: J5.2, U1.D3
BUTTON+: J4.2, U1.D13
D8TEST: TP3.TP, U1.D8
GND: C7.-, C8.-, C-DECOUP-BJT.2, C_DECOUPL_5V.2, DC1.2 (GND), J3.1, J4.1, J5.1, PAD3.1, PAD4.1, PAD5.1, Q1.3 (S), R2.1, R3.1, R5.1, T2.1 (E), U1.GND, U1.GND1, U1.GND2, X1.2
LICK_IN: R6.1, T2.3 (C), TP5.TP, U1.D2
unnamed: Q1.1 (G), R4.2
unnamed: D1.A, J1.2, Q1.2 (D)
unnamed: C-DECOUP-BJT.1, R3.2, T1.1 (E), T2.2 (B)
unnamed: R1.1, R2.2, T1.2 (B)
SENSOR-: J2.2, R1.2
SWITCH_INPUT: J3.2, U1.A0
VALVE_OUT: R4.1, R5.2, TP6.TP, U1.D6

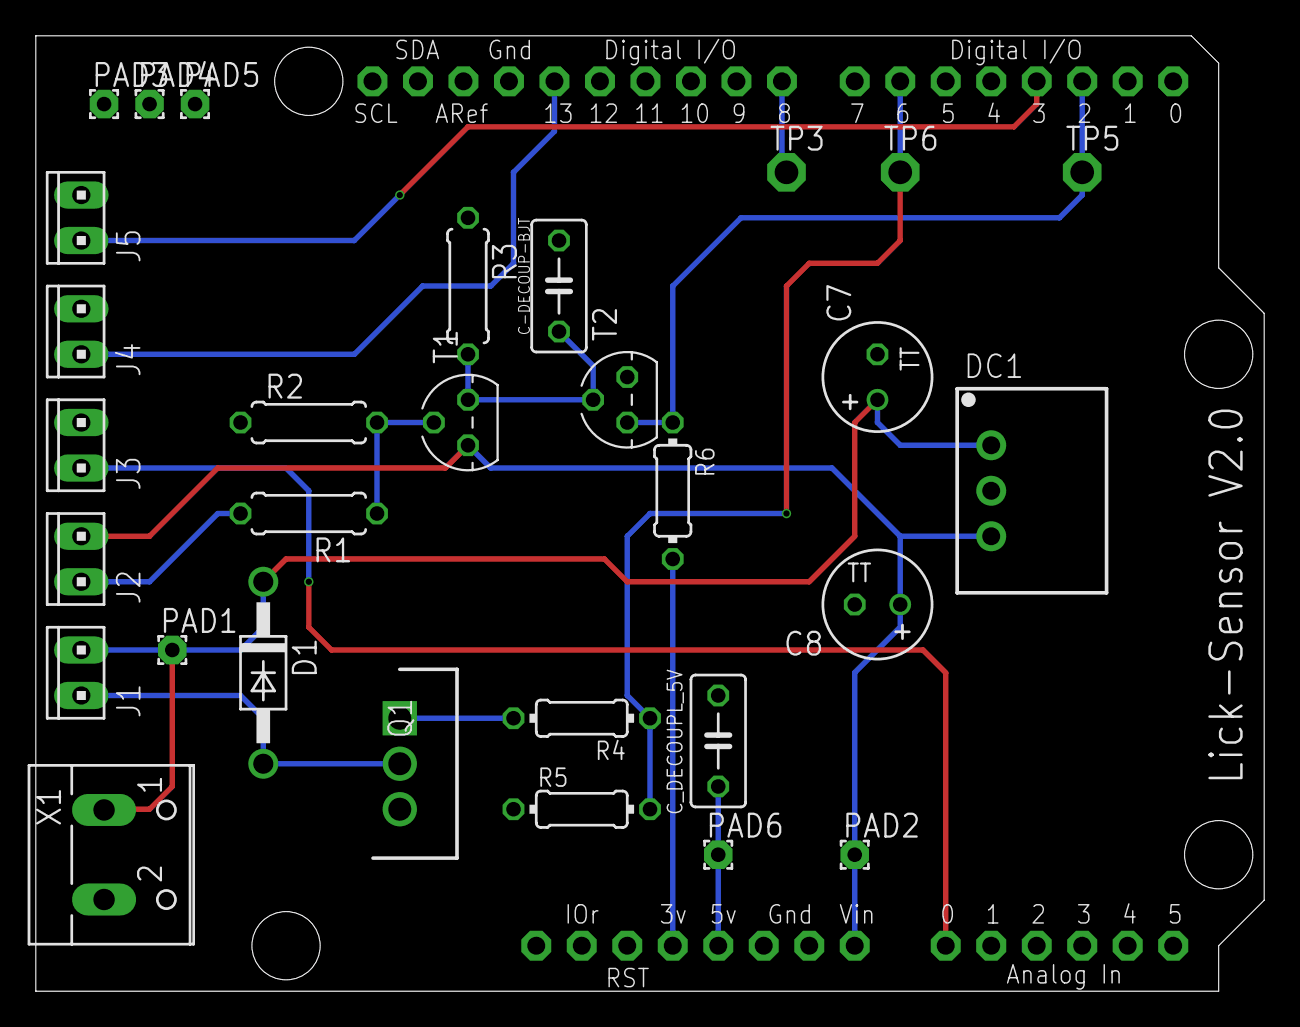
[picture p37: board LickSensor_V2.brd from above]

Board: 2 copper layers, 68.6 x 53.3 mm, 31 parts (0 on the bottom side), 16 nets.
