maverstr/Lick-Sensor/(commit log)

2019-09-16 added eagle files
    [LickSensor.brd, LickSensor.sch, LickSensor_V2.brd, LickSensor_V2.sch, LickSensor_V3.brd, LickSensor_V3.sch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]
2019-09-16 added enable interrupt lib
2019-09-25 added bill of mat
    [BillOfMatLickSensor.xlsx]
2019-09-25 updated eagle
    [BillOfMatLickSensor.xlsx]
2019-09-25 updated eagle files
    [LickSensor_V3.brd, LickSensor_V3.sch]
2019-09-27 updated SW files
    [Amphenal_031_10_RFXG1.SLDPRT, Arduino UNO.SLDPRT, Arduino_Wifi_Shield.SLDPRT, Bouton 2 Positions Green.SLDPRT, Button Push.SLDPRT, DC Jack Panel Mount ASSY.SLDPRT, Enclosure.SLDPRT, Enclosure1.SLDDRW]
2019-10-01 renamed multiple variables + added hardware interface for drain valve
2019-10-01 Added specific debounce delay for toggle switches
2019-10-01 Added init setup for toggle switches
